Klangstrom/klangstrom-libraries/README.md

*Klangstrom* (KLST) is a subtractive infrastructure design framework to facilitate generative, networked, embedded sound + music + composition. *klangstrom* is comprised of two software libraries ( *klang* a node+text-based sound synthesis library and *strom* a node+text-based generative composition library ), an embedded hardware platform, and a programming environment to allow seamless development of generative, networked, embedded sound + music + composition applications.

---

contains a series of libraries that are mostly but not exclusively used by the *Arduino IDE* or `arduino-cli`. *klangstrom-libraries* are used ( as git *subtree* ) in the repositories *klangstrom-hardware* and *klangstrom-arduino*.

libraries included in *klangstrom-libraries*:

```sh
klangstrom-libraries
├── Klangstrom
├── Klangstrom_Emulator
├── Klangstrom_KLST_EMU                
├── Klangstrom_KLST_PANDA_STM32        
├── Klangstrom_KLST_PANDA_STM32_CubeMX 
├── USBDevices
└── USBHost # <- ⚠️ WIP ⚠️ currently broken
```

### Klangstrom

*Klangstrom* is the library that applications interact with. it defines the *Klangstrom API*. 

### Klangstrom_Emulator

infrastructure for running *Klangstrom* emulators. it is based on [Umfeld for Arduino](https://github.com/klangstrom/umfeld-arduino). it tries to mimic some *Arduino* functions but by far not every available function.

this library is usually not used directly.

### Klangstrom_KLST_EMU

implementation of *Klangstrom API* for running on the emulator. currently emulates *KLST_PANDA* and *KLST_CATERPILLAR*.

### Klangstrom_KLST_PANDA_STM32

implementation of board-specific (BSP) functions of the *Klangstrom API* for *KLST_PANDA* and *KLST_CATERPILLAR*.

this library is usually not used directly.

### Klangstrom_KLST_PANDA_STM32_CubeMX

low-level firmware files generated by STM32CubeMX with definitions found in the *project configuration files* ( `.ioc` ) in the `klangstrom-hardware` repository.

this library is usually not used directly.

### USBDevices

⚠️⚠️⚠️ WIP library is currently broken ⚠️⚠️⚠️

USB device library for STM32H7 devices. in USB terminology a *device* is a peripheral that is connect *to* a *host* e.g a keyboard, mouse or audio interface.

### USBHost

⚠️⚠️⚠️ WIP library is currently broken ⚠️⚠️⚠️ 

USB host library for STM32H7 devices. in USB terminology a *host* allows *devices* to connect to it. this library implements a sub-set of *Human-Interface Devices* (HID):

- keyboard
- mouse
- MIDI

<!-- 

## notes ==@todo==

- first initialize the hardware layer with `.init()` then setup device and peripherals with `.setup()` ( e.g start timers, data transfer, and callbacks )
- each board-specific (BSP) implementation is stored in it’s own library ( e.g `‌Klangstrom_KLST_PANDA_STM32` )

## environment

==@todo==

## Klangstrom

==@todo==
```
### File Naming Conventions

- `BSP` == Board Specific  > `KlangstromApplication_KLST_SHEEP-BSP`
- `SAB` == Shared Across Boards ( within an Architexture ) > `Klangstrom_ARDUINO-SAB.cpp`
```

==@todo("Klangstrom requires to set the environment in `KLST_ENV` at compile time. `KLST_ENV` defines architecture (`KLST_ARCH`) and board (`KLST_BOARD`):")==

```
KLST_ENV = KLST_ARCH + KLST_BOARD

.
├── KLST_ARCH                       (=0x10)
│   ├── KLST_ARCH_STM32             (=0x20) (Arduino,MCU) + (STM32CubeIDE,MCU)
│   └── KLST_ARCH_EMU               (=0x30) (Arduino,CPU)
└── KLST_BOARD                      (=0x01)
    ├── KLST_BOARD_KLST_CORE        (=0x02) (STM32H743+WM8731)
    ├── KLST_BOARD_KLST_TINY        (=0x03) (STM32F446+WM8731)
    ├── KLST_BOARD_KLST_SHEEP       (=0x04) (STM32H743+WM8731)
    ├── KLST_BOARD_KLST_PANDA       (=0x05) (STM32H723+WM8904)
    └── KLST_BOARD_KLST_CATERPILLAR (=0x06) (STM32H723+WM8904)
```

the following prepocessor conditionals can be used:

```
#if ((KLST_ENV & KLST_ARCH) == KLST_ARCH_STM32)
// running on STM32
#endif

#if ((KLST_ENV & KLST_BOARD) == KLST_BOARD_KLST_PANDA)
// running on KLST_PANDA
#endif
```

there are common files ( e.g `Klangstrom.cpp` ) and board-specific (BSP) files ( `Klangstrom-BSP-KLST_PANDA.cpp` ). the common files are used by all boards and architectures.

- `Klangstrom.h`
- `Klangstrom.cpp`
- `Klangstrom-KLST_PANDA.h`
- `Klangstrom-KLST_PANDA.cpp`
- `Klangstrom-Display.h`
- `Klangstrom-Display.cpp`
- `Klangstrom-KLST_PANDA-Display.h`
- `Klangstrom-KLST_PANDA-Display.cpp`
- ...

### architectures ==@todo==

available architectures are:

- SOFT/DESKTOP @TODO(need to decide on name)
- METAL/STM32 @TODO(need to decide on name)

programatically identifiable e.g

```
#if (KLST_ARCHITECTURE_METAL)
#endif // KLST_ARCHITECTURE_METAL
```

### boards ==@todo==

available boards are for `METAL`:

- `KLST_PANDA`
- `KLST_SHEEP`
- `KLST_TINY`

and for `SOFT`:

- `KLST_EMU`
- `KLST_STANDALONE` ==@todo== @NOTE(not sure about this one)

programatically identifiable e.g

```
#if defined(KLST_BOARD_KLST_PANDA)
#endif // KLST_BOARD_KLST_PANDA
```

## Board-Specific (BSP) implementations

all boards need to implement the following functions

```
KLST_BSP_init()
KLST_BSP_setup()
KLST_BSP_loop()
```

in a file called `Klangstrom_BSP_XXX.cpp` where `XXX` is the board and architecture ( e.g `KLST_PANDA_STM32` ).

### STM32

on `STM32` architecture this file usually also includes the HAL callbacks.

 -->
