Klangstrom/klangstrom-libraries/Klangstrom_KLST_PANDA_STM32_CubeMX/src/main.h

#define KLST_DISPLAY_FRAMEBUFFER_ADDRESS   0x90000000
#define KLST_DISPLAY_WIDTH                 480
#define KLST_DISPLAY_HEIGHT                272
#define SPI_USR_SCK_Pin                    GPIO_PIN_2
#define SPI_USR_SCK_GPIO_Port              GPIOE
#define _AUDIO_CODEC_SAI_SD_OUT_Pin        GPIO_PIN_3
#define _AUDIO_CODEC_SAI_SD_OUT_GPIO_Port  GPIOE
#define SPI_USR_CS_Pin                     GPIO_PIN_4
#define SPI_USR_CS_GPIO_Port               GPIOE
#define SPI_USR_MISO_Pin                   GPIO_PIN_5
#define SPI_USR_MISO_GPIO_Port             GPIOE
#define SPI_USR_MOSI_Pin                   GPIO_PIN_6
#define SPI_USR_MOSI_GPIO_Port             GPIOE
#define GPIO_10_Pin                        GPIO_PIN_13
#define GPIO_10_GPIO_Port                  GPIOC
#define GPIO_09_Pin                        GPIO_PIN_14
#define GPIO_09_GPIO_Port                  GPIOC
#define GPIO_08_Pin                        GPIO_PIN_15
#define GPIO_08_GPIO_Port                  GPIOC
#define GPIO_03_PWM_Pin                    GPIO_PIN_0
#define GPIO_03_PWM_GPIO_Port              GPIOF
#define GPIO_02_PWM_Pin                    GPIO_PIN_1
#define GPIO_02_PWM_GPIO_Port              GPIOF
#define GPIO_01_PWM_Pin                    GPIO_PIN_2
#define GPIO_01_PWM_GPIO_Port              GPIOF
#define GPIO_00_PWM_Pin                    GPIO_PIN_3
#define GPIO_00_PWM_GPIO_Port              GPIOF
#define GPIO_07_Pin                        GPIO_PIN_4
#define GPIO_07_GPIO_Port                  GPIOF
#define _ADC_USR_Pin                       GPIO_PIN_5
#define _ADC_USR_GPIO_Port                 GPIOF
#define _EXT_MEMORY_A3_Pin                 GPIO_PIN_6
#define _EXT_MEMORY_A3_GPIO_Port           GPIOF
#define _AUDIO_CODEC_SAI_MCLK_Pin          GPIO_PIN_7
#define _AUDIO_CODEC_SAI_MCLK_GPIO_Port    GPIOF
#define _AUDIO_CODEC_SAI_SCK_Pin           GPIO_PIN_8
#define _AUDIO_CODEC_SAI_SCK_GPIO_Port     GPIOF
#define _AUDIO_CODEC_SAI_FS_Pin            GPIO_PIN_9
#define _AUDIO_CODEC_SAI_FS_GPIO_Port      GPIOF
#define _EXT_MEMORY_CLK_Pin                GPIO_PIN_10
#define _EXT_MEMORY_CLK_GPIO_Port          GPIOF
#define _RCC_OSC_IN_Pin                    GPIO_PIN_0
#define _RCC_OSC_IN_GPIO_Port              GPIOH
#define _RCC_OSC_OUT_Pin                   GPIO_PIN_1
#define _RCC_OSC_OUT_GPIO_Port             GPIOH
#define _DISPLAY_LTDC_R5_Pin               GPIO_PIN_0
#define _DISPLAY_LTDC_R5_GPIO_Port         GPIOC
#define _DISPLAY_LTDC_G5_Pin               GPIO_PIN_1
#define _DISPLAY_LTDC_G5_GPIO_Port         GPIOC
#define _AUDIO_MIC_CLK_Pin                 GPIO_PIN_2
#define _AUDIO_MIC_CLK_GPIO_Port           GPIOC
#define _AUDIO_MIC_DATA_Pin                GPIO_PIN_3
#define _AUDIO_MIC_DATA_GPIO_Port          GPIOC
#define _ENCODER_01_A_Pin                  GPIO_PIN_0
#define _ENCODER_01_A_GPIO_Port            GPIOA
#define _ENCODER_01_B_Pin                  GPIO_PIN_1
#define _ENCODER_01_B_GPIO_Port            GPIOA
#define _DISPLAY_LTDC_R1_Pin               GPIO_PIN_2
#define _DISPLAY_LTDC_R1_GPIO_Port         GPIOA
#define SERIAL_USR_RX_Pin                  GPIO_PIN_3
#define SERIAL_USR_RX_GPIO_Port            GPIOA
#define _DAC_USR_Pin                       GPIO_PIN_4
#define _DAC_USR_GPIO_Port                 GPIOA
#define _DISPLAY_LTDC_R4_Pin               GPIO_PIN_5
#define _DISPLAY_LTDC_R4_GPIO_Port         GPIOA
#define _DISPLAY_LTDC_G2_Pin               GPIO_PIN_6
#define _DISPLAY_LTDC_G2_GPIO_Port         GPIOA
#define _DISPLAY_LTDC_VSYNC_Pin            GPIO_PIN_7
#define _DISPLAY_LTDC_VSYNC_GPIO_Port      GPIOA
#define _DISPLAY_ON_OFF_Pin                GPIO_PIN_4
#define _DISPLAY_ON_OFF_GPIO_Port          GPIOC
#define _EXT_MEMORY_DQS_Pin                GPIO_PIN_5
#define _EXT_MEMORY_DQS_GPIO_Port          GPIOC
#define _DISPLAY_LTDC_G1_Pin               GPIO_PIN_0
#define _DISPLAY_LTDC_G1_GPIO_Port         GPIOB
#define _DISPLAY_LTDC_G0_Pin               GPIO_PIN_1
#define _DISPLAY_LTDC_G0_GPIO_Port         GPIOB
#define _AUDIO_CODEC_SAI_SD_IN_Pin         GPIO_PIN_2
#define _AUDIO_CODEC_SAI_SD_IN_GPIO_Port   GPIOB
#define GPIO_05_ADC_Pin                    GPIO_PIN_11
#define GPIO_05_ADC_GPIO_Port              GPIOF
#define _BUTTON_PROGRAMMER_Pin             GPIO_PIN_12
#define _BUTTON_PROGRAMMER_GPIO_Port       GPIOF
#define GPIO_04_ADC_Pin                    GPIO_PIN_13
#define GPIO_04_ADC_GPIO_Port              GPIOF
#define _I2C_PERIPHERAL_SCL_Pin            GPIO_PIN_14
#define _I2C_PERIPHERAL_SCL_GPIO_Port      GPIOF
#define _I2C_PERIPHERAL_SDA_Pin            GPIO_PIN_15
#define _I2C_PERIPHERAL_SDA_GPIO_Port      GPIOF
#define _IDC_SERIAL_01_RX_Pin              GPIO_PIN_0
#define _IDC_SERIAL_01_RX_GPIO_Port        GPIOG
#define _IDC_SERIAL_01_TX_Pin              GPIO_PIN_1
#define _IDC_SERIAL_01_TX_GPIO_Port        GPIOG
#define _EXT_MEMORY_A4_Pin                 GPIO_PIN_7
#define _EXT_MEMORY_A4_GPIO_Port           GPIOE
#define _EXT_MEMORY_A5_Pin                 GPIO_PIN_8
#define _EXT_MEMORY_A5_GPIO_Port           GPIOE
#define _EXT_MEMORY_A6_Pin                 GPIO_PIN_9
#define _EXT_MEMORY_A6_GPIO_Port           GPIOE
#define _EXT_MEMORY_A7_Pin                 GPIO_PIN_10
#define _EXT_MEMORY_A7_GPIO_Port           GPIOE
#define _ENCODER_00_B_Pin                  GPIO_PIN_11
#define _ENCODER_00_B_GPIO_Port            GPIOE
#define _DISPLAY_LTDC_B4_Pin               GPIO_PIN_12
#define _DISPLAY_LTDC_B4_GPIO_Port         GPIOE
#define _DISPLAY_LTDC_DE_Pin               GPIO_PIN_13
#define _DISPLAY_LTDC_DE_GPIO_Port         GPIOE
#define GPIO_17_Pin                        GPIO_PIN_14
#define GPIO_17_GPIO_Port                  GPIOE
#define _DISPLAY_LTDC_R7_Pin               GPIO_PIN_15
#define _DISPLAY_LTDC_R7_GPIO_Port         GPIOE
#define _DISPLAY_LTDC_G4_Pin               GPIO_PIN_10
#define _DISPLAY_LTDC_G4_GPIO_Port         GPIOB
#define _ENCODER_01_BUTTON_Pin             GPIO_PIN_11
#define _ENCODER_01_BUTTON_GPIO_Port       GPIOB
#define _EXT_MEMORY_A0_Pin                 GPIO_PIN_12
#define _EXT_MEMORY_A0_GPIO_Port           GPIOB
#define _EXT_MEMORY_A2_Pin                 GPIO_PIN_13
#define _EXT_MEMORY_A2_GPIO_Port           GPIOB
#define _LED_00_Pin                        GPIO_PIN_14
#define _LED_00_GPIO_Port                  GPIOB
#define _LED_01_Pin                        GPIO_PIN_15
#define _LED_01_GPIO_Port                  GPIOB
#define _SERIAL_DEBUG_TX_Pin               GPIO_PIN_8
#define _SERIAL_DEBUG_TX_GPIO_Port         GPIOD
#define _SERIAL_DEBUG_RX_Pin               GPIO_PIN_9
#define _SERIAL_DEBUG_RX_GPIO_Port         GPIOD
#define _DISPLAY_LTDC_B3_Pin               GPIO_PIN_10
#define _DISPLAY_LTDC_B3_GPIO_Port         GPIOD
#define GPIO_06_Pin                        GPIO_PIN_11
#define GPIO_06_GPIO_Port                  GPIOD
#define _EXT_MEMORY_A1_Pin                 GPIO_PIN_12
#define _EXT_MEMORY_A1_GPIO_Port           GPIOD
#define _DISPLAY_TOUCH_INTERRUPT_Pin       GPIO_PIN_13
#define _DISPLAY_TOUCH_INTERRUPT_GPIO_Port GPIOD
#define _DISPLAY_TOUCH_INTERRUPT_EXTI_IRQn EXTI15_10_IRQn
#define _MECH_BUTTON_00_Pin                GPIO_PIN_14
#define _MECH_BUTTON_00_GPIO_Port          GPIOD
#define _MECH_BUTTON_00_EXTI_IRQn          EXTI15_10_IRQn
#define _MECH_BUTTON_01_Pin                GPIO_PIN_15
#define _MECH_BUTTON_01_GPIO_Port          GPIOD
#define _MECH_BUTTON_01_EXTI_IRQn          EXTI15_10_IRQn
#define GPIO_16_Pin                        GPIO_PIN_2
#define GPIO_16_GPIO_Port                  GPIOG
#define GPIO_15_Pin                        GPIO_PIN_3
#define GPIO_15_GPIO_Port                  GPIOG
#define GPIO_14_Pin                        GPIO_PIN_4
#define GPIO_14_GPIO_Port                  GPIOG
#define GPIO_13_Pin                        GPIO_PIN_5
#define GPIO_13_GPIO_Port                  GPIOG
#define _EXT_MEMORY_CHIP_SELECT_Pin        GPIO_PIN_6
#define _EXT_MEMORY_CHIP_SELECT_GPIO_Port  GPIOG
#define _DISPLAY_LTDC_CLK_Pin              GPIO_PIN_7
#define _DISPLAY_LTDC_CLK_GPIO_Port        GPIOG
#define _DISPLAY_LTDC_G7_Pin               GPIO_PIN_8
#define _DISPLAY_LTDC_G7_GPIO_Port         GPIOG
#define _DISPLAY_LTDC_HSYNC_Pin            GPIO_PIN_6
#define _DISPLAY_LTDC_HSYNC_GPIO_Port      GPIOC
#define _DISPLAY_LTDC_G6_Pin               GPIO_PIN_7
#define _DISPLAY_LTDC_G6_GPIO_Port         GPIOC
#define _DISPLAY_BACKLIGHT_PWM_Pin         GPIO_PIN_8
#define _DISPLAY_BACKLIGHT_PWM_GPIO_Port   GPIOC
#define _DISPLAY_LTDC_G3_Pin               GPIO_PIN_9
#define _DISPLAY_LTDC_G3_GPIO_Port         GPIOC
#define _ENCODER_00_A_Pin                  GPIO_PIN_8
#define _ENCODER_00_A_GPIO_Port            GPIOA
#define _USB_DEVICE_HOST_VBUS_Pin          GPIO_PIN_9
#define _USB_DEVICE_HOST_VBUS_GPIO_Port    GPIOA
#define _ENCODER_00_BUTTON_Pin             GPIO_PIN_10
#define _ENCODER_00_BUTTON_GPIO_Port       GPIOA
#define _USB_DEVICE_HOST_MINUS_Pin         GPIO_PIN_11
#define _USB_DEVICE_HOST_MINUS_GPIO_Port   GPIOA
#define _USB_DEVICE_HOST_PLUS_Pin          GPIO_PIN_12
#define _USB_DEVICE_HOST_PLUS_GPIO_Port    GPIOA
#define _SWD_IO_Pin                        GPIO_PIN_13
#define _SWD_IO_GPIO_Port                  GPIOA
#define _SWD_CLK_Pin                       GPIO_PIN_14
#define _SWD_CLK_GPIO_Port                 GPIOA
#define _DISPLAY_LTDC_R3_Pin               GPIO_PIN_15
#define _DISPLAY_LTDC_R3_GPIO_Port         GPIOA
#define _DISPLAY_LTDC_R2_Pin               GPIO_PIN_10
#define _DISPLAY_LTDC_R2_GPIO_Port         GPIOC
#define _MIDI_ANALOG_IN_Pin                GPIO_PIN_11
#define _MIDI_ANALOG_IN_GPIO_Port          GPIOC
#define _DISPLAY_LTDC_R6_Pin               GPIO_PIN_12
#define _DISPLAY_LTDC_R6_GPIO_Port         GPIOC
#define _DISPLAY_LTDC_B1_Pin               GPIO_PIN_0
#define _DISPLAY_LTDC_B1_GPIO_Port         GPIOD
#define _MIDI_ANALOG_OUT_Pin               GPIO_PIN_1
#define _MIDI_ANALOG_OUT_GPIO_Port         GPIOD
#define _DISPLAY_LTDC_B2_Pin               GPIO_PIN_2
#define _DISPLAY_LTDC_B2_GPIO_Port         GPIOD
#define GPIO_18_Pin                        GPIO_PIN_3
#define GPIO_18_GPIO_Port                  GPIOD
#define GPIO_12_Pin                        GPIO_PIN_4
#define GPIO_12_GPIO_Port                  GPIOD
#define SERIAL_USR_TX_Pin                  GPIO_PIN_5
#define SERIAL_USR_TX_GPIO_Port            GPIOD
#define _CARD_SDMMC_CK_Pin                 GPIO_PIN_6
#define _CARD_SDMMC_CK_GPIO_Port           GPIOD
#define _CARD_SDMMC_CMD_Pin                GPIO_PIN_7
#define _CARD_SDMMC_CMD_GPIO_Port          GPIOD
#define _CARD_SDMMC_D0_Pin                 GPIO_PIN_9
#define _CARD_SDMMC_D0_GPIO_Port           GPIOG
#define _CARD_SDMMC_D1_Pin                 GPIO_PIN_10
#define _CARD_SDMMC_D1_GPIO_Port           GPIOG
#define _CARD_SDMMC_D2_Pin                 GPIO_PIN_11
#define _CARD_SDMMC_D2_GPIO_Port           GPIOG
#define _CARD_SDMMC_D3_Pin                 GPIO_PIN_12
#define _CARD_SDMMC_D3_GPIO_Port           GPIOG
#define _DISPLAY_LTDC_R0_Pin               GPIO_PIN_13
#define _DISPLAY_LTDC_R0_GPIO_Port         GPIOG
#define _DISPLAY_LTDC_B0_Pin               GPIO_PIN_14
#define _DISPLAY_LTDC_B0_GPIO_Port         GPIOG
#define _CARD_SDMMC_CHIP_DETECT_Pin        GPIO_PIN_15
#define _CARD_SDMMC_CHIP_DETECT_GPIO_Port  GPIOG
#define _SWD_OUT_Pin                       GPIO_PIN_3
#define _SWD_OUT_GPIO_Port                 GPIOB
#define GPIO_11_Pin                        GPIO_PIN_4
#define GPIO_11_GPIO_Port                  GPIOB
#define _DISPLAY_LTDC_B5_Pin               GPIO_PIN_5
#define _DISPLAY_LTDC_B5_GPIO_Port         GPIOB
#define I2C_USR_SCL_Pin                    GPIO_PIN_6
#define I2C_USR_SCL_GPIO_Port              GPIOB
#define I2C_USR_SDA_Pin                    GPIO_PIN_7
#define I2C_USR_SDA_GPIO_Port              GPIOB
#define _DISPLAY_LTDC_B6_Pin               GPIO_PIN_8
#define _DISPLAY_LTDC_B6_GPIO_Port         GPIOB
#define _DISPLAY_LTDC_B7_Pin               GPIO_PIN_9
#define _DISPLAY_LTDC_B7_GPIO_Port         GPIOB
#define _IDC_SERIAL_00_RX_Pin              GPIO_PIN_0
#define _IDC_SERIAL_00_RX_GPIO_Port        GPIOE
#define _IDC_SERIAL_00_TX_Pin              GPIO_PIN_1
#define _IDC_SERIAL_00_TX_GPIO_Port        GPIOE
