Klangstrom/klangstrom-libraries/Klangstrom/src/KlangstromEnvironment.h

/*
 * Klangstrom
 *
 * This file is part of the *Klangstrom* library (https://github.com/dennisppaul/klangstrom-libraries).
 * Copyright (c) 2025 Dennis P Paul.
 *
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
 * You should have received a copy of the GNU General Public License
 * along with this program. If not, see <http://www.gnu.org/licenses/>.
 */

/* --- THIS FILE IS AUTOGENERATED --- */

#pragma once

// #define KLST_DEBUG_ENVIRONMENT

#define KLST_ARCH 0x10
#define KLST_ARCH_RESERVED 0x20
#define KLST_ARCH_STM32 0x30
#define KLST_ARCH_EMU 0x40
#define KLST_ARCH_MASK 0xF0

#define KLST_BOARD 0x01
#define KLST_BOARD_GENERIC 0x02
#define KLST_BOARD_KLST_CORE 0x03
#define KLST_BOARD_KLST_TINY 0x04
#define KLST_BOARD_KLST_SHEEP 0x05
#define KLST_BOARD_KLST_PANDA 0x06
#define KLST_BOARD_KLST_CATERPILLAR 0x07
#define KLST_BOARD_MASK 0x0F

#ifndef KLST_ENV
#error "define KLST_ENV with (KLST_ARCH | KLST_BOARD) or (KLST_ARCH + KLST_BOARD) e.g KLST_PANDA on STM32: (KLST_BOARD_KLST_PANDA + KLST_ARCH_STM32) = (0x20 + 0x05) = 0x25"

#else

// GENERIC

#if ((KLST_ENV & KLST_BOARD_MASK) == KLST_BOARD_GENERIC) && ((KLST_ENV & KLST_ARCH_MASK) == KLST_ARCH_RESERVED)
#define KLST_ARCH_IS_RESERVED
#define GENERIC_RESERVED // = 0x22
#ifdef KLST_DEBUG_ENVIRONMENT
#warning "+++ klangstrom platform: GENERIC_RESERVED"
#endif // KLST_DEBUG_ENVIRONMENT
#endif // GENERIC_RESERVED

#if ((KLST_ENV & KLST_BOARD_MASK) == KLST_BOARD_GENERIC) && ((KLST_ENV & KLST_ARCH_MASK) == KLST_ARCH_STM32)
#define KLST_ARCH_IS_STM32
#define GENERIC_STM32 // = 0x32
#ifdef KLST_DEBUG_ENVIRONMENT
#warning "+++ klangstrom platform: GENERIC_STM32"
#endif // KLST_DEBUG_ENVIRONMENT
#endif // GENERIC_STM32

#if ((KLST_ENV & KLST_BOARD_MASK) == KLST_BOARD_GENERIC) && ((KLST_ENV & KLST_ARCH_MASK) == KLST_ARCH_EMU)
#define KLST_ARCH_IS_EMU
#define GENERIC_EMU // = 0x42
#ifdef KLST_DEBUG_ENVIRONMENT
#warning "+++ klangstrom platform: GENERIC_EMU"
#endif // KLST_DEBUG_ENVIRONMENT
#endif // GENERIC_EMU

// KLST_CORE

#if ((KLST_ENV & KLST_BOARD_MASK) == KLST_BOARD_KLST_CORE) && ((KLST_ENV & KLST_ARCH_MASK) == KLST_ARCH_RESERVED)
#define KLST_ARCH_IS_RESERVED
#define KLST_CORE_RESERVED // = 0x23
#ifdef KLST_DEBUG_ENVIRONMENT
#warning "+++ klangstrom platform: KLST_CORE_RESERVED"
#endif // KLST_DEBUG_ENVIRONMENT
#endif // KLST_CORE_RESERVED

#if ((KLST_ENV & KLST_BOARD_MASK) == KLST_BOARD_KLST_CORE) && ((KLST_ENV & KLST_ARCH_MASK) == KLST_ARCH_STM32)
#define KLST_ARCH_IS_STM32
#define KLST_CORE_STM32 // = 0x33
#ifdef KLST_DEBUG_ENVIRONMENT
#warning "+++ klangstrom platform: KLST_CORE_STM32"
#endif // KLST_DEBUG_ENVIRONMENT
#endif // KLST_CORE_STM32

#if ((KLST_ENV & KLST_BOARD_MASK) == KLST_BOARD_KLST_CORE) && ((KLST_ENV & KLST_ARCH_MASK) == KLST_ARCH_EMU)
#define KLST_ARCH_IS_EMU
#define KLST_CORE_EMU // = 0x43
#ifdef KLST_DEBUG_ENVIRONMENT
#warning "+++ klangstrom platform: KLST_CORE_EMU"
#endif // KLST_DEBUG_ENVIRONMENT
#endif // KLST_CORE_EMU

// KLST_TINY

#if ((KLST_ENV & KLST_BOARD_MASK) == KLST_BOARD_KLST_TINY) && ((KLST_ENV & KLST_ARCH_MASK) == KLST_ARCH_RESERVED)
#define KLST_ARCH_IS_RESERVED
#define KLST_TINY_RESERVED // = 0x24
#ifdef KLST_DEBUG_ENVIRONMENT
#warning "+++ klangstrom platform: KLST_TINY_RESERVED"
#endif // KLST_DEBUG_ENVIRONMENT
#endif // KLST_TINY_RESERVED

#if ((KLST_ENV & KLST_BOARD_MASK) == KLST_BOARD_KLST_TINY) && ((KLST_ENV & KLST_ARCH_MASK) == KLST_ARCH_STM32)
#define KLST_ARCH_IS_STM32
#define KLST_TINY_STM32 // = 0x34
#ifdef KLST_DEBUG_ENVIRONMENT
#warning "+++ klangstrom platform: KLST_TINY_STM32"
#endif // KLST_DEBUG_ENVIRONMENT
#endif // KLST_TINY_STM32

#if ((KLST_ENV & KLST_BOARD_MASK) == KLST_BOARD_KLST_TINY) && ((KLST_ENV & KLST_ARCH_MASK) == KLST_ARCH_EMU)
#define KLST_ARCH_IS_EMU
#define KLST_TINY_EMU // = 0x44
#ifdef KLST_DEBUG_ENVIRONMENT
#warning "+++ klangstrom platform: KLST_TINY_EMU"
#endif // KLST_DEBUG_ENVIRONMENT
#endif // KLST_TINY_EMU

// KLST_SHEEP

#if ((KLST_ENV & KLST_BOARD_MASK) == KLST_BOARD_KLST_SHEEP) && ((KLST_ENV & KLST_ARCH_MASK) == KLST_ARCH_RESERVED)
#define KLST_ARCH_IS_RESERVED
#define KLST_SHEEP_RESERVED // = 0x25
#ifdef KLST_DEBUG_ENVIRONMENT
#warning "+++ klangstrom platform: KLST_SHEEP_RESERVED"
#endif // KLST_DEBUG_ENVIRONMENT
#endif // KLST_SHEEP_RESERVED

#if ((KLST_ENV & KLST_BOARD_MASK) == KLST_BOARD_KLST_SHEEP) && ((KLST_ENV & KLST_ARCH_MASK) == KLST_ARCH_STM32)
#define KLST_ARCH_IS_STM32
#define KLST_SHEEP_STM32 // = 0x35
#ifdef KLST_DEBUG_ENVIRONMENT
#warning "+++ klangstrom platform: KLST_SHEEP_STM32"
#endif // KLST_DEBUG_ENVIRONMENT
#endif // KLST_SHEEP_STM32

#if ((KLST_ENV & KLST_BOARD_MASK) == KLST_BOARD_KLST_SHEEP) && ((KLST_ENV & KLST_ARCH_MASK) == KLST_ARCH_EMU)
#define KLST_ARCH_IS_EMU
#define KLST_SHEEP_EMU // = 0x45
#ifdef KLST_DEBUG_ENVIRONMENT
#warning "+++ klangstrom platform: KLST_SHEEP_EMU"
#endif // KLST_DEBUG_ENVIRONMENT
#endif // KLST_SHEEP_EMU

// KLST_PANDA

#if ((KLST_ENV & KLST_BOARD_MASK) == KLST_BOARD_KLST_PANDA) && ((KLST_ENV & KLST_ARCH_MASK) == KLST_ARCH_RESERVED)
#define KLST_ARCH_IS_RESERVED
#define KLST_PANDA_RESERVED // = 0x26
#ifdef KLST_DEBUG_ENVIRONMENT
#warning "+++ klangstrom platform: KLST_PANDA_RESERVED"
#endif // KLST_DEBUG_ENVIRONMENT
#endif // KLST_PANDA_RESERVED

#if ((KLST_ENV & KLST_BOARD_MASK) == KLST_BOARD_KLST_PANDA) && ((KLST_ENV & KLST_ARCH_MASK) == KLST_ARCH_STM32)
#define KLST_ARCH_IS_STM32
#define KLST_PANDA_STM32 // = 0x36
#ifdef KLST_DEBUG_ENVIRONMENT
#warning "+++ klangstrom platform: KLST_PANDA_STM32"
#endif // KLST_DEBUG_ENVIRONMENT
#endif // KLST_PANDA_STM32

#if ((KLST_ENV & KLST_BOARD_MASK) == KLST_BOARD_KLST_PANDA) && ((KLST_ENV & KLST_ARCH_MASK) == KLST_ARCH_EMU)
#define KLST_ARCH_IS_EMU
#define KLST_PANDA_EMU // = 0x46
#ifdef KLST_DEBUG_ENVIRONMENT
#warning "+++ klangstrom platform: KLST_PANDA_EMU"
#endif // KLST_DEBUG_ENVIRONMENT
#endif // KLST_PANDA_EMU

// KLST_CATERPILLAR

#if ((KLST_ENV & KLST_BOARD_MASK) == KLST_BOARD_KLST_CATERPILLAR) && ((KLST_ENV & KLST_ARCH_MASK) == KLST_ARCH_RESERVED)
#define KLST_ARCH_IS_RESERVED
#define KLST_CATERPILLAR_RESERVED // = 0x27
#ifdef KLST_DEBUG_ENVIRONMENT
#warning "+++ klangstrom platform: KLST_CATERPILLAR_RESERVED"
#endif // KLST_DEBUG_ENVIRONMENT
#endif // KLST_CATERPILLAR_RESERVED

#if ((KLST_ENV & KLST_BOARD_MASK) == KLST_BOARD_KLST_CATERPILLAR) && ((KLST_ENV & KLST_ARCH_MASK) == KLST_ARCH_STM32)
#define KLST_ARCH_IS_STM32
#define KLST_CATERPILLAR_STM32 // = 0x37
#ifdef KLST_DEBUG_ENVIRONMENT
#warning "+++ klangstrom platform: KLST_CATERPILLAR_STM32"
#endif // KLST_DEBUG_ENVIRONMENT
#endif // KLST_CATERPILLAR_STM32

#if ((KLST_ENV & KLST_BOARD_MASK) == KLST_BOARD_KLST_CATERPILLAR) && ((KLST_ENV & KLST_ARCH_MASK) == KLST_ARCH_EMU)
#define KLST_ARCH_IS_EMU
#define KLST_CATERPILLAR_EMU // = 0x47
#ifdef KLST_DEBUG_ENVIRONMENT
#warning "+++ klangstrom platform: KLST_CATERPILLAR_EMU"
#endif // KLST_DEBUG_ENVIRONMENT
#endif // KLST_CATERPILLAR_EMU

#endif // KLST_ENV
