Klangstrom/klangstrom-libraries/Klangstrom_Emulator/standalone/src/MWavetable.h

/*
 * Klangwellen
 *
 * This file is part of the *Klangwellen* library (https://github.com/dennisppaul/klangwellen).
 * Copyright (c) 2025 Dennis P Paul
 *
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
 * You should have received a copy of the GNU General Public License
 * along with this program. If not, see <http://www.gnu.org/licenses/>.
 */

/**
 * PROCESSOR INTERFACE
 *
 * - [x] float process()
 * - [ ] float process(float)
 * - [ ] void process(Signal&)
 * - [x] void process(float*, uint32_t) *overwrite*
 * - [ ] void process(float*, float*, uint32_t)
 */

#pragma once

#include <stdint.h>
#include <math.h>

#ifndef PI
#define PI M_PI
#endif

#ifndef TWO_PI
#define TWO_PI (M_PI * 2)
#endif

#ifndef HALF_PI
#define HALF_PI (M_PI / 2)
#endif

/**
 * plays back a chunk of samples ( i.e arbitrary, single-cycle waveform like sine, triangle, saw or square waves ) at
 * different frequencies and amplitudes.
 */
class MWavetable {
public:
    static constexpr uint8_t WAVEFORM_SINE                = 0;
    static constexpr uint8_t WAVEFORM_TRIANGLE            = 1;
    static constexpr uint8_t WAVEFORM_SQUARE              = 3;
    static constexpr uint8_t WAVESHAPE_INTERPOLATE_NONE   = 0;
    static constexpr uint8_t WAVESHAPE_INTERPOLATE_LINEAR = 1;
    static constexpr uint8_t WAVESHAPE_INTERPOLATE_CUBIC  = 2;


    MWavetable(float* wavetable, const uint32_t wavetable_size, const uint32_t sampling_rate) : mWavetableSize(wavetable_size),
                                                                                               mSamplingRate(sampling_rate),
                                                                                               mFrequency(0) {
        mWavetable                = wavetable;
        fDeleteWavetable          = false;
        mArrayPtr                 = 0;
        mJitterRange              = 0.0f;
        mAmplitude                = M_DEFAULT_AMPLITUDE;
        mPhaseOffset              = 0.0f;
        mDesiredAmplitude         = 0.0f;
        mDesiredAmplitudeFraction = 0.0f;
        mDesiredAmplitudeSteps    = 0;
        set_frequency(M_DEFAULT_FREQUENCY);
    }

    ~MWavetable() {
        if (fDeleteWavetable) {
            delete[] mWavetable;
        }
    }

    static void fill(float* wavetable, const uint32_t wavetable_size, const uint8_t waveform) {
        switch (waveform) {
            case WAVEFORM_SINE:
                sine(wavetable, wavetable_size);
                break;
            case WAVEFORM_TRIANGLE:
                triangle(wavetable, wavetable_size);
                break;
            case WAVEFORM_SQUARE:
                square(wavetable, wavetable_size);
                break;
            default:
                sine(wavetable, wavetable_size);
        }
    }

    static void pulse(float* wavetable, const uint32_t wavetable_size, const float pulse_width) {
        const uint32_t mThreshold = static_cast<uint32_t>(wavetable_size * pulse_width);
        for (uint32_t i = 0; i < wavetable_size; i++) {
            if (i < mThreshold) {
                wavetable[i] = 1.0f;
            } else {
                wavetable[i] = -1.0f;
            }
        }
    }

    static void sawtooth_ramp(float* wavetable, const uint32_t wavetable_size, const bool is_ramp_up) {
        const float mSign = is_ramp_up ? -1.0f : 1.0f;
        for (uint32_t i = 0; i < wavetable_size; i++) {
            wavetable[i] = mSign * (2.0f * (static_cast<float>(i) / static_cast<float>(wavetable_size - 1)) - 1.0f);
        }
    }

    static void sine(float* wavetable, const uint32_t wavetable_size) {
        for (uint32_t i = 0; i < wavetable_size; i++) {
            wavetable[i] = sin(2.0f * PIf * (static_cast<float>(i) / static_cast<float>(wavetable_size)));
        }
    }

    static void square(float* wavetable, const uint32_t wavetable_size) {
        for (uint32_t i = 0; i < wavetable_size / 2; i++) {
            wavetable[i]                      = 1.0f;
            wavetable[i + wavetable_size / 2] = -1.0f;
        }
    }

    static void triangle(float* wavetable, const uint32_t wavetable_size) {
        const uint32_t q  = wavetable_size / 4;
        const float    qf = wavetable_size * 0.25f;
        for (uint32_t i = 0; i < q; i++) {
            wavetable[i] = i / qf;
            // noinspection PointlessArithmeticExpression
            wavetable[i + (q * 1)] = (qf - i) / qf;
            wavetable[i + (q * 2)] = -i / qf;
            wavetable[i + (q * 3)] = -(qf - i) / qf;
        }
    }

    void set_waveform(const uint8_t waveform) const {
        fill(mWavetable, mWavetableSize, waveform);
    }

    float get_frequency() const {
        return mFrequency;
    }

    void set_frequency(const float frequency) {
        const float mNewFrequency = fabs(frequency);
        if (mFrequency != mNewFrequency) {
            mFrequency = mNewFrequency;
            mStepSize  = computeStepSize();
        }
    }

    /**
     * alternative version of `set_frequency` which takes a second paramter that specifies the duration in samples from
     * current to new value. this can prevent unwanted artifacts ( e.g when quickly changing values ). it can also be
     * used to create glissando or portamento effects.
     *
     * @param frequency                         destination frequency
     * @param interpolation_duration_in_samples duration of interpolation in samples
     */
    void set_frequency(const float frequency, const uint16_t interpolation_duration_in_samples) {
        if (interpolation_duration_in_samples > 0) {
            mDesiredFrequency           = frequency;
            mDesiredFrequencySteps      = interpolation_duration_in_samples;
            const float mFrequencyDelta = mDesiredFrequency - mFrequency;
            mDesiredFrequencyFraction   = mFrequencyDelta / interpolation_duration_in_samples;
        } else {
            set_frequency(frequency);
        }
    }

    float get_offset() const {
        return mOffset;
    }

    void set_offset(const float offset) {
        mOffset = offset;
    }

    float get_amplitude() const {
        return mAmplitude;
    }

    /**
     * @param amplitude amplitude
     */

    void set_amplitude(const float amplitude) {
        mAmplitude             = amplitude;
        mDesiredAmplitudeSteps = 0;
    }

    /**
     * alternative version of `set_amplitude` which takes a second paramter that specifies the duration in samples from
     * current to new value. this can prevent unwanted artifacts ( e.g crackling noise when changing amplitude quickly
     * especially on smoother wave shape like sine waves ). it can also be used to create glissando or portamento
     * effects.
     *
     * @param amplitude                         destination amplitude
     * @param interpolation_duration_in_samples duration of interpolation in samples
     */
    void set_amplitude(const float amplitude, const uint32_t interpolation_duration_in_samples) {
        if (interpolation_duration_in_samples > 0) {
            mDesiredAmplitude           = amplitude;
            mDesiredAmplitudeSteps      = interpolation_duration_in_samples;
            const float mAmplitudeDelta = mDesiredAmplitude - mAmplitude;
            mDesiredAmplitudeFraction   = mAmplitudeDelta / interpolation_duration_in_samples;
        } else {
            set_amplitude(amplitude);
        }
    }

    float* get_wavetable() const {
        return mWavetable;
    }

    uint32_t get_wavetable_size() const {
        return mWavetableSize;
    }

    float get_phase_offset() const {
        return mPhaseOffset;
    }

    void set_phase_offset(const float phase_offset) {
        mPhaseOffset = phase_offset < 0 ? 1 + phase_offset : phase_offset;
    }

    float get_jitter_range() const {
        return mJitterRange;
    }

    void set_jitter_range(const float jitter_range) {
        mJitterRange = jitter_range;
    }

    void reset() {
        mSignal   = 0.0f;
        mArrayPtr = 0.0f;
    }

    float current() const {
        return mSignal;
    }

    /**
     * set speed of oscillator in seconds per phase
     *
     * @param frequency oscillation speed on seconds per phase ( or Hz )
     */
    void set_oscillation_speed(const float frequency) {
        set_frequency(1.0f / frequency);
    }

    /**
     * set output value range of oscillator in minimum and maximum. this method affects the oscillator’s amplitude and
     * offset. this methods can be particularily helpful when using an oscillator for non-audio applications ( e.g as an
     * LFO that controlls the frequency ).
     *
     * @param min minimum output value of oscillator
     * @param max maximum output value of oscillator
     */
    void set_oscillation_range(const float min, const float max) {
        const float mDelta = max - min;
        set_amplitude(mDelta * 0.5f);
        set_offset(mDelta * 0.5f + min);
    }

    float process() {
        if (mDesiredAmplitudeSteps > 0) {
            mDesiredAmplitudeSteps--;
            if (mDesiredAmplitudeSteps == 0) {
                mAmplitude = mDesiredAmplitude;
            } else {
                mAmplitude += mDesiredAmplitudeFraction;
            }
        }

        if (mDesiredFrequencySteps > 0) {
            mDesiredFrequencySteps--;
            if (mDesiredFrequencySteps == 0) {
                set_frequency(mDesiredFrequency);
            } else {
                set_frequency(mFrequency + mDesiredFrequencyFraction);
            }
        }

        mSignal = next_sample();

        mSignal *= mAmplitude;
        mSignal += mOffset;
        return mSignal;
    }

    void process(float* signal_buffer, const uint32_t buffer_length) {
        for (uint16_t i = 0; i < buffer_length; i++) {
            signal_buffer[i] = process();
        }
    }

private:
    static constexpr float PIf                 = (float) PI;
    static constexpr float TWO_PIf             = (float) TWO_PI;
    static constexpr float M_DEFAULT_AMPLITUDE = 0.75f;
    static constexpr float M_DEFAULT_FREQUENCY = 220.0f;
    float*                 mWavetable;
    const uint32_t         mWavetableSize;
    const uint32_t         mSamplingRate;
    bool                   fDeleteWavetable;
    float                  mAmplitude;
    float                  mArrayPtr;
    float                  mDesiredAmplitude;
    float                  mDesiredAmplitudeFraction;
    uint16_t               mDesiredAmplitudeSteps;
    float                  mDesiredFrequency;
    float                  mDesiredFrequencyFraction;
    uint16_t               mDesiredFrequencySteps;
    float                  mFrequency;
    float                  mJitterRange;
    float                  mOffset;
    float                  mPhaseOffset;
    float                  mSignal;
    float                  mStepSize;

    void advance_array_ptr() {
        // mArrayPtr += mStepSize * (mEnableJitter ? (klangwellen::Klangwellen::random() * mJitterRange + 1.0f) : 1.0f);
        // mArrayPtr += mStepSize;
        mArrayPtr += mStepSize;
        while (mArrayPtr >= mWavetableSize) {
            mArrayPtr -= mWavetableSize;
        }
        while (mArrayPtr < 0) {
            mArrayPtr += mWavetableSize;
        }
    }

    float computeStepSize() const {
        return mFrequency * (static_cast<float>(mWavetableSize) / static_cast<float>(mSamplingRate));
    }

    float next_sample() {
        const float mOutput = mWavetable[static_cast<int>(mArrayPtr)];
        advance_array_ptr();
        return mOutput;
    }
};
