Klangstrom/klangstrom-libraries/Klangstrom_Emulator/standalone/src/KLST--logotype-128x128.h

#pragma once
#include <cstdint>
// generated from: KLST--logotype-128x128.png

struct KLST__logotype_128x128 {
  static constexpr std::uint32_t WIDTH  = 128;
  static constexpr std::uint32_t HEIGHT = 128;
  static inline const std::uint32_t DATA[WIDTH * HEIGHT] = {
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
};
};
