Klangstrom/klangstrom-libraries/Klangstrom_KLST_PANDA_STM32/src/WM8904Configure.cpp

/*
* Klangstrom
*
* This file is part of the *Klangstrom* library (https://github.com/dennisppaul/klangstrom-libraries).
* Copyright (c) 2025 Dennis P Paul.
*
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
* You should have received a copy of the GNU General Public License
* along with this program. If not, see <http://www.gnu.org/licenses/>.
*/

#include "KlangstromEnvironment.h"
#ifdef KLST_ARCH_IS_STM32
#include "PeripheralConfiguration_STM32.h"
#ifdef KLST_PERIPHERAL_ENABLE_AUDIODEVICE

#include <cstdio>
#include <cstdint>
#include "main.h"

#include "Console.h"
#include "WM8904Configure.h"
#include "WM8904.h"

#ifdef __cplusplus
extern "C" {
#endif

static void delay_ms(uint32_t duration) {
    HAL_Delay(duration);
}

static void set_lineout_volume(uint8_t volume_left, uint8_t volume_right) {
    WM8904_write_register(WM8904_R59_ANALOGUE_OUT2_LEFT, WM8904_LINEOUT_VU | WM8904_LINEOUTL_VOL(volume_left));
    WM8904_write_register(WM8904_R60_ANALOGUE_OUT2_RIGHT, WM8904_LINEOUT_VU | WM8904_LINEOUTR_VOL(volume_right));
}

static void set_headphone_volume(uint8_t volume_left, uint8_t volume_right) {
    WM8904_write_register(WM8904_R57_ANALOGUE_OUT1_LEFT, WM8904_HPOUT_VU | WM8904_HPOUTL_VOL(volume_left));
    WM8904_write_register(WM8904_R58_ANALOGUE_OUT1_RIGHT, WM8904_HPOUT_VU | WM8904_HPOUTR_VOL(volume_right));
}

static void setup_manually() {
    /* --- POWER ---------------------------------------------------------------------------------------------------- */
    WM8904_write_register(WM8904_BIAS_CONTROL_0, WM8904_ISEL_HP_BIAS);
    WM8904_write_register(WM8904_VMID_CONTROL_0, WM8904_VMID_BUF_ENA | WM8904_VMID_RES_FAST | WM8904_VMID_ENA);
    delay_ms(5);
    WM8904_write_register(WM8904_VMID_CONTROL_0, WM8904_VMID_BUF_ENA | WM8904_VMID_RES_NORMAL | WM8904_VMID_ENA);
    WM8904_write_register(WM8904_BIAS_CONTROL_0, WM8904_ISEL_HP_BIAS | WM8904_BIAS_ENA);
    WM8904_write_register(WM8904_POWER_MANAGEMENT_0, WM8904_INL_ENA | WM8904_INR_ENA);
    WM8904_write_register(WM8904_POWER_MANAGEMENT_2, WM8904_HPL_PGA_ENA | WM8904_HPR_PGA_ENA);
    WM8904_write_register(WM8904_DAC_DIGITAL_1, WM8904_DEEMPH(0));
    WM8904_write_register(WM8904_ANALOGUE_OUT12_ZC, 0x0000);
    WM8904_write_register(WM8904_CHARGE_PUMP_0, WM8904_CP_ENA);
    WM8904_write_register(WM8904_CLASS_W_0, WM8904_CP_DYN_PWR);

    /* --- AUDIO_INTERFACE ------------------------------------------------------------------------------------------ */
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
