Klangstrom/klangstrom-libraries/(commit log)

2021-05-04 moved files from main repo
    ( commit history of KLST_CORE + KLST_TINY is available at main repository )
    [ButtonDebounced.sch, KLST_CORE-BOM.csv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]
2021-05-04 made links to footprint + schematics library relative
2021-05-04 swapped SDCARD_CS + GPIO_02 to allow *hardware* CS
    [KLST_CORE.sch]
2021-05-17 added note for ARM-JTAG connector
    [KLST_TINY.kicad_pcb]
2021-07-23 updated version
    [ButtonDebounced.sch, KLST_TINY.sch, audio_codec_WM8731.sch, peripherals_uart_i2c_spi.sch, rotary_encoder__with_push_button.sch]
2021-10-11 updated schematics, started PCB
    [ButtonDebounced.sch, KLST_SHEEP.kicad_pcb, KLST_SHEEP.sch, audio_codec_WM8731.sch, peripherals_uart_i2c_spi.sch, rotary_encoder__with_push_button.sch]
2021-10-14 reworking PCB into *handheld* version
    [KLST_SHEEP.kicad_pcb]
2021-10-28 minor changes
    [KLST_SHEEP.kicad_pcb, KLST_SHEEP.sch]
2021-11-01 added NHD display
    [ButtonDebounced.sch, KLST_SHEEP.kicad_pcb, KLST_SHEEP.sch, audio_codec_WM8731.sch, peripherals_uart_i2c_spi.sch, rotary_encoder__with_push_button.sch]
2021-11-03 added screen, added icon
    [ButtonDebounced.sch, KLST_SHEEP.kicad_pcb, KLST_SHEEP.sch, audio_codec_WM8731.sch, peripherals_uart_i2c_spi.sch, rotary_encoder__with_push_button.sch]
2021-11-04 updated capabilites, updated GPIOs
    [ButtonDebounced.sch, KLST_SHEEP.kicad_pcb, KLST_SHEEP.sch, peripherals_uart_i2c_spi.sch]
2021-11-05 cleaned up
    [KLST_SHEEP.kicad_pcb, KLST_SHEEP.sch]
2021-11-05 added icons
    [ButtonDebounced.sch, KLST_SHEEP.kicad_pcb, KLST_SHEEP.sch, audio_codec_WM8731.sch, peripherals_uart_i2c_spi.sch, rotary_encoder__with_push_button.sch]
2021-11-06 finished PIN assignment, cleaned up silkscreen
    READY TO ROUTE :)
    [KLST_SHEEP.kicad_pcb, KLST_SHEEP.sch, peripherals_uart_i2c_spi.sch]
2021-11-06 updated info and tech details
    [KLST_SHEEP.sch]
2021-11-08 routed audio codec + connectors
    [KLST_SHEEP.kicad_pcb]
2021-11-08 started routing GPIOs + LEDs
    [KLST_SHEEP.kicad_pcb, KLST_SHEEP.sch, peripherals_uart_i2c_spi.sch, rotary_encoder__with_push_button.sch]
2021-11-08 finalized PCB design (v0.1)
    [KLST_SHEEP.kicad_pcb, KLST_SHEEP.sch, rotary_encoder__with_push_button.sch]
2021-11-25 added KLST_GRASS ( power + protoyping board )
    [KLST_GRASS.kicad_pcb, KLST_GRASS.sch, KLST_SHEEP.sch, charger_stepup.sch]
2021-11-25 finished schematics, started PCB design
    [KLST_GRASS.kicad_pcb, KLST_GRASS.sch]
2021-11-26 fixed components not showing in position file ( set to SMD )
    [KLST_GRASS.kicad_pcb, KLST_SHEEP.kicad_pcb]
2021-12-02 reversed LED naming
    [KLST_SHEEP.kicad_pcb, KLST_SHEEP.sch]
2021-12-03 updated pin map
2021-12-04 added LED timer map
2022-05-17 updated timer pin maps
2022-09-05 cleaned up release
    [KLST_TINY-BOM.csv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]
2022-09-08 added STM32H723ZGT6
    [KLST_PANDA.kicad_pcb, KLST_PANDA.kicad_sch]
2022-09-29 added STM32CubeIDE board configuration
2022-09-29 renamed board file folder
2022-10-02 added external memory + SDMMC card
    [KLST_PANDA.kicad_sch]
2022-10-04 added audiocodec
    [KLST_PANDA.kicad_pcb, KLST_PANDA.kicad_sch]
2022-10-05 rearranged pins, added modules from KLST_SHEEP
    [KLST_PANDA.kicad_sch]
2023-02-03 added KLST_SPIDER
    [KLST_SPIDER.kicad_pcb, KLST_SPIDER.kicad_sch]
2023-02-04 added connectors, created round PCB
    [KLST_SPIDER.kicad_pcb, KLST_SPIDER.kicad_sch]
2023-02-04 added MIDI THRU
    [KLST_SPIDER.kicad_pcb, KLST_SPIDER.kicad_sch]
2023-02-05 rearranged connectors
    [KLST_SPIDER.kicad_pcb, KLST_SPIDER.kicad_sch]
2023-02-06 prepared JLPCPB production
    [KLST_SPIDER.kicad_pcb, KLST_SPIDER.kicad_sch, klst_satellite.kicad_sch]
2023-02-06 renamed project, routed traces
    [KLST_OCTOPUS.kicad_pcb, KLST_OCTOPUS.kicad_sch, KLST_SPIDER.kicad_pcb, klst_satellite.kicad_sch]
2023-02-07 finished PCB routing
    [KLST_OCTOPUS.kicad_pcb, KLST_OCTOPUS.kicad_sch]
2023-02-07 finalized PCB
    [KLST_OCTOPUS.kicad_pcb, KLST_OCTOPUS.kicad_sch, klst_satellite.kicad_sch]
2023-02-07 fixed schematics
    [KLST_OCTOPUS.kicad_sch, klst_satellite.kicad_sch]
2023-02-07 updated LCSC #
    [KLST_OCTOPUS.kicad_sch, klst_satellite.kicad_sch]
2023-02-07 added LCSC #
    [KLST_OCTOPUS.kicad_pcb]
2023-02-07 prepared components for production
    [KLST_OCTOPUS.kicad_pcb, KLST_OCTOPUS.kicad_sch, bom.csv, designators.csv, klst_satellite.kicad_sch, positions.csv]
2023-02-08 corrected C1 ( to 100nF )
    [KLST_OCTOPUS.kicad_pcb, KLST_OCTOPUS.kicad_sch, bom.csv]
2023-02-20 fixed bug with TX + buffer
    [KLST_OCTOPUS.kicad_sch, klst_satellite.kicad_sch]
2023-02-22 KLST_SHEEP rotated diodes at UARTs
    [ButtonDebounced.kicad_sch, KLST_SHEEP.kicad_sch, audio_codec_WM8731.kicad_sch, peripherals_uart_i2c_spi.kicad_sch, rotary_encoder__with_push_button.kicad_sch]
2023-04-11 updated pin configuration
2023-04-11 optimized timer pins
2023-04-14 added components
    [KLST_PANDA.kicad_sch]
2023-05-02 added backlight PWM
2023-05-08 added KLST_SOIL
    [BOM-KLST_SOIL.csv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]
2023-05-22 added pin map
    [KLST_PANDA-STM32H723ZGT-BSP--pin_map.csv]
2023-08-04 separated sections into sheets
    [KLST_PANDA.kicad_pcb, KLST_PANDA.kicad_sch, audio_codec.kicad_sch, display.kicad_sch, external_memory.kicad_sch, sd_card.kicad_sch]
2023-08-07 updated architecture, switch mechanical key pins
    [KLST_PANDA-STM32H723ZGT-BSP--pin_map.csv]
2023-08-08 rearrange mechanical key pins, migrated to TP5400 charging circuit
    [KLST_PANDA.kicad_sch, battery.kicad_sch]
2023-08-10 added backlight circuit, started capacitive touch driver
    [KLST_PANDA.kicad_sch, battery.kicad_sch, display.kicad_sch]
2023-08-16 updated display module
    [KLST_PANDA.kicad_pcb, display.kicad_sch]
2023-08-17 added, rotary encoders, updated pin assignment, updated system architecture
    [KLST_PANDA-STM32H723ZGT-BSP--pin_map.csv, KLST_PANDA.kicad_sch, battery.kicad_sch, display.kicad_sch, rotary_encoder.kicad_sch, rotary_encoders.kicad_sch]
2023-08-17 added IDC, updated pin names
    [IDC_serial.kicad_sch, IDC_serials.kicad_sch, KLST_PANDA-STM32H723ZGT-BSP--pin_map.csv, KLST_PANDA.kicad_sch, rotary_encoders.kicad_sch]
2023-08-17 added MIDI analog, I2C and buttons
    [I2C.kicad_sch, IDC_serials.kicad_sch, KLST_PANDA.kicad_sch, MIDI_analog.kicad_sch, button_debounced.kicad_sch, buttons.kicad_sch]
2023-08-17 added USB-C connectors
    [KLST_PANDA.kicad_sch, USB.kicad_sch, battery.kicad_sch]
2023-08-18 cleaned up main sheet
    [KLST_PANDA.kicad_sch, MIDI_analog.kicad_sch, USB.kicad_sch, audio_codec.kicad_sch, battery.kicad_sch, display.kicad_sch]
2023-08-22 updated pin names, configured all pins and most peripherals,
    [ADC_DAC.kicad_sch, GPIO.kicad_sch, KLST_PANDA-STM32H723ZGT-BSP--pin_map.csv, KLST_PANDA.kicad_sch, audio_codec.kicad_sch, buttons.kicad_sch, display.kicad_sch, external_memory.kicad_sch]
2023-08-23 improved GPIO, updated schematics
    [ADC_DAC.kicad_sch, GPIO.kicad_sch, I2C.kicad_sch, IDC_serial.kicad_sch, KLST_PANDA.kicad_sch, MIDI_analog.kicad_sch, USB.kicad_sch, audio_codec.kicad_sch]
2023-08-23 added PDM interface ( and removed SAI )
    [GPIO.kicad_sch, KLST_PANDA-STM32H723ZGT-BSP--pin_map.csv, KLST_PANDA.kicad_sch, on-board_mic.kicad_sch]
2023-08-23 added MEMS mics
    [on-board_mic.kicad_sch]
2023-08-24 added mechanical keys, updated audio jacks, minor changes
    [ADC_DAC.kicad_sch, GPIO.kicad_sch, KLST_PANDA.kicad_pcb, KLST_PANDA.kicad_sch, MIDI_analog.kicad_sch, USB.kicad_sch, audio_codec.kicad_sch, buttons.kicad_sch]
2023-08-28 moved core (MCU) to sheet, cleaned up sheets
    [ADC_DAC.kicad_sch, GPIO.kicad_sch, I2C.kicad_sch, IDC_serial.kicad_sch, IDC_serials.kicad_sch, KLST_PANDA.kicad_sch, MIDI_analog.kicad_sch, USB.kicad_sch]
2023-08-28 started cleaning up schematic ( addressing DRC errors/warning ) (WIP)
    [ADC_DAC.kicad_sch, GPIO.kicad_sch, I2C.kicad_sch, IDC_serial.kicad_sch, KLST_PANDA.kicad_sch, MIDI_analog.kicad_sch, USB.kicad_sch, audio_codec.kicad_sch]
2023-08-29 changed `GPIO_20` to `GPIO_06` ( which was missing )
    [GPIO.kicad_sch, KLST_PANDA-STM32H723ZGT-BSP--pin_map.csv, core.kicad_sch]
2023-08-29 added battery clip, updated to new KiCad version
    [ADC_DAC.kicad_sch, GPIO.kicad_sch, IDC_serial.kicad_sch, KLST_PANDA.kicad_pcb, KLST_PANDA.kicad_sch, MIDI_analog.kicad_sch, USB.kicad_sch, audio_codec.kicad_sch]
2023-08-29 updated encoder symbol, ignored simulation errors
    [rotary_encoder.kicad_sch]
2023-08-29 updated 74AHC1G125 symbol
    [MIDI_analog.kicad_sch]
2023-08-29 update SD card symbol
    [sd_card.kicad_sch]
2023-08-29 removed DRC warnings and error, added power page
    [ADC_DAC.kicad_sch, GPIO.kicad_sch, I2C.kicad_sch, IDC_serial.kicad_sch, KLST_PANDA.kicad_sch, MIDI_analog.kicad_sch, USB.kicad_sch, audio_codec.kicad_sch]
2023-08-30 changed I2C label, display can now be switched on and off
    [ADC_DAC.kicad_sch, GPIO.kicad_sch, I2C.kicad_sch, IDC_serial.kicad_sch, KLST_PANDA.kicad_sch, MIDI_analog.kicad_sch, USB.kicad_sch, audio_codec.kicad_sch]
2023-08-31 unified internal I2C bus, cleaned up, added ESD protection to USB
    [ADC_DAC.kicad_sch, GPIO.kicad_sch, IDC_serial.kicad_sch, KLST_PANDA-STM32H723ZGT-BSP--pin_map.csv, KLST_PANDA.kicad_sch, MIDI_analog.kicad_sch, USB.kicad_sch, audio_codec.kicad_sch]
2023-08-31 removed GDNA
    [ADC_DAC.kicad_sch, GPIO.kicad_sch, IDC_serial.kicad_sch, MIDI_analog.kicad_sch, USB.kicad_sch, audio_codec.kicad_sch, battery.kicad_sch, button_debounced.kicad_sch]
2023-08-31 resolved TODOs
    [ADC_DAC.kicad_sch, KLST_PANDA.kicad_sch, MIDI_analog.kicad_sch, USB.kicad_sch, audio_codec.kicad_sch, battery.kicad_sch, core.kicad_sch, display.kicad_sch]
2023-08-31 started spec'ing components
    [ADC_DAC.kicad_sch, GPIO.kicad_sch, IDC_serial.kicad_sch, KLST_PANDA.kicad_pcb, KLST_PANDA.kicad_sch, MIDI_analog.kicad_sch, USB.kicad_sch, audio_codec.kicad_sch]
2023-09-01 assigned footprints
    [ADC_DAC.kicad_sch, GPIO.kicad_sch, KLST_PANDA.kicad_pcb, KLST_PANDA.kicad_sch, MIDI_analog.kicad_sch, USB.kicad_sch, audio_codec.kicad_sch, battery.kicad_sch]
2023-09-01 cleaned up footprint assignment
    [ADC_DAC.kicad_sch, GPIO.kicad_sch, IDC_serial.kicad_sch, KLST_PANDA.kicad_sch, MIDI_analog.kicad_sch, USB.kicad_sch, audio_codec.kicad_sch, battery.kicad_sch]
2023-09-02 added slider switch
    [KLST_PANDA.kicad_pcb, battery.kicad_sch]
2023-09-04 fixed 3D models, started sketch PCB layout
    [KLST_PANDA.kicad_pcb, KLST_PANDA.kicad_sch, on-board_mic.kicad_sch]
2023-09-05 started design + PCB layout research
    [KLST_PANDA.kicad_pcb]
2023-09-05 spec'd layers, restarted components placement
    [KLST_PANDA.kicad_pcb]
2023-09-05 lining up things for routing
    [KLST_PANDA.kicad_pcb]
2023-09-09 arranged components
    [KLST_PANDA.kicad_pcb]
2023-09-10 distributed modules
    [GPIO.kicad_sch, IDC_serial.kicad_sch, KLST_PANDA.kicad_pcb, KLST_PANDA.kicad_sch, USB.kicad_sch, audio_codec.kicad_sch, battery.kicad_sch, core.kicad_sch]
2023-09-11 spec'd capabilites, routed external memory
    [KLST_PANDA.kicad_pcb]
2023-09-13 finished positioning all components
    [KLST_PANDA.kicad_pcb]
2023-09-14 routed some components
    [KLST_PANDA.kicad_pcb, USB.kicad_sch, battery.kicad_sch, programmer.kicad_sch, rotary_encoder.kicad_sch]
2023-09-28 routed audio codec
    [KLST_PANDA.kicad_pcb]
2023-09-29 routed LCD + audio codec
    [KLST_PANDA.kicad_pcb]
2023-10-04 continued routing
    [IDC_serials.kicad_sch, KLST_PANDA.kicad_pcb, USB.kicad_sch, core.kicad_sch]
2023-10-04 routed GPIO
    [KLST_PANDA.kicad_pcb]
2023-10-05 completed routing, passed DRC
    [KLST_PANDA.kicad_pcb]
2023-10-05 moved ports
    [KLST_PANDA.kicad_pcb]
2023-10-06 added ( maybe fit ) Samtec FTSH-107-01-F-DV-K for programmer
    [programmer.kicad_sch]
2023-12-11 added TP5400, added labels
    [KLST_PANDA.kicad_pcb]
2023-12-11 added production files
    [BOM-KLST_PANDA.csv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]
2023-12-19 added resistor and capacitor, cleaned up TODOs
    [ADC_DAC.kicad_sch, GPIO.kicad_sch, IDC_serial.kicad_sch, KLST_PANDA.kicad_pcb, KLST_PANDA.kicad_sch, MIDI_analog.kicad_sch, USB.kicad_sch, audio_codec.kicad_sch]
2023-12-20 finalized PCB layout
    [KLST_PANDA.kicad_pcb, battery.kicad_sch, display.kicad_sch]
2023-12-20 generated production files
    [BOM-KLST_PANDA.csv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]
2023-12-20 changed via size to 0.3mm
    [KLST_PANDA.kicad_pcb]
2023-12-20 updated production files
    [KLST_PANDA-CuBottom.gbr, KLST_PANDA-CuIn1.gbr, KLST_PANDA-CuIn2.gbr, KLST_PANDA-CuIn3.gbr, KLST_PANDA-CuIn4.gbr, KLST_PANDA-CuTop.gbr, KLST_PANDA-EdgeCuts.gbr, KLST_PANDA-MaskBottom.gbr]
2023-12-20 removed mounting holes from BOM
    [BOM-KLST_PANDA.csv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]
2023-12-20 replaced R42
    [BOM-KLST_PANDA.csv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]
2024-01-10 production version
    [KLST_PANDA-CuBottom.gbr, KLST_PANDA-CuIn1.gbr, KLST_PANDA-CuIn2.gbr, KLST_PANDA-CuIn3.gbr, KLST_PANDA-CuIn4.gbr, KLST_PANDA-CuTop.gbr, KLST_PANDA-EdgeCuts.gbr, KLST_PANDA-MaskBottom.gbr]
2024-01-12 fixed hole size issue with audio jacks
    [KLST_PANDA-CuBottom.gbr, KLST_PANDA-CuIn1.gbr, KLST_PANDA-CuIn2.gbr, KLST_PANDA-CuIn3.gbr, KLST_PANDA-CuIn4.gbr, KLST_PANDA-CuTop.gbr, KLST_PANDA-EdgeCuts.gbr, KLST_PANDA-MaskBottom.gbr]
2024-01-12 replaced audio jack
    [KLST_PANDA.kicad_pcb]
2024-01-12 changed vias to 0.5/0.2mm, removed edge cut from footprint
    [KLST_PANDA.kicad_pcb]
2024-01-12 replaced audio jacks and fixed all errors and warnings
    [KLST_PANDA.kicad_pcb]
2024-01-12 finalized production files
    [BOM-KLST_PANDA.csv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]
2024-01-31 started testing KLST_PANDA board
    [KLST_PANDA-STM32H723ZGT-BSP Debug.cfg]
2024-02-02 started updating PCB
    [ADC_DAC.kicad_sch, GPIO.kicad_sch, IDC_serial.kicad_sch, KLST_PANDA.kicad_sch, MIDI_analog.kicad_sch, USB.kicad_sch, audio_codec.kicad_sch, battery.kicad_sch]
2024-02-02 external memory is working … but misses a few spots
2024-02-02 ext memory is now ALMOST working …
2024-02-04 LCD clears background now … but does not update
2024-02-04 LCD works now with DMA2D
    … not exactly sure what i am doing here though ;)
2024-02-05 set LCD GPIO pin speeds to very high
2024-02-05 imporved OCTO-SPI performance
2024-02-10 audiocodec still not working
    [KLST_PANDA-AudioCodec.c, KLST_PANDA-SerialDebug.h, WM8904.h]
2024-02-12 clean up, still not working
    [KLST_PANDA-AudioCodec.c]
2024-02-13 fixed D-chache issue with DMA
    [KLST_PANDA-AudioCodec.c]
2024-02-15 PDM mic not working yet
    [KLST_PANDA-AudioCodec.c]
2024-02-17 minor changes … PDM MIC still not working
    [KLST_PANDA-AudioCodec.c]
2024-02-17 started encoders ( in C++ ), minor changes
2024-02-18 added SDCard support ( no DMA )
2024-02-19 started adding IDC ( still not working :( )
    [KLST_PANDA.cpp, main.h]
2024-02-20 fixed project file, still struggling with UART
    [KLST_PANDA.cpp]
2024-02-21 struggling with UART … still
2024-02-21 added buffer to UART ( still only semi functional )
2024-02-21 UART … puuuuh :(
    [MIDI_analog.kicad_sch]
2024-02-22 adde coding style, added rotary encoder,
2024-02-25 enabled DMA for SD Card
2024-02-25 cleaned up MIDI
    [MIDI_analog.kicad_sch]
2024-02-25 updated kicad files to 8.0
    [ADC_DAC.kicad_sch, GPIO.kicad_sch, IDC_serial.kicad_sch, IDC_serials.kicad_sch, KLST_PANDA.kicad_pcb, KLST_PANDA.kicad_sch, MIDI_analog.kicad_sch, USB.kicad_sch]
2024-02-26 UART8 uses DMA now
2024-02-26 added USB Host, enabled DMA for UART4+9 ( but not using it yet )
2024-02-26 added USB Device ( but deactivated )
2024-02-27 added ADC + DAC
2024-02-28 final got MIDI to work ( not sure if it is now TYPE A or B ;) )
    [MIDI_analog.kicad_sch]
2024-02-29 added display off when not used
    [MIDI_analog.kicad_sch]
2024-03-01 added on board mic files, deleted linker script *RAM.ld
2024-03-06 added report, update pin map
    [KLST_PANDA-STM32H723ZGT-BSP--pin_map.csv]
2024-03-13 added +1.8V power, removed SS14, added decoupling capacitor to MEMS mic
    [MIDI_analog.kicad_sch, audio_codec.kicad_sch, battery.kicad_sch, on-board_mic.kicad_sch, power.kicad_sch]
2024-03-13 rearranged SPI and added DFSDM
    [GPIO.kicad_sch, core.kicad_sch]
2024-03-13 added DFSDM channels + filters
2024-03-13 removed SAI from on-board mic
2024-03-14 removed SS14, moved `SPI_USR` to `SPI4` use `SPI2` for MEMS microphones, added decoupling caps to MEMS microphone, added +1.8V, fixed audio codec power supply
    [KLST_PANDA.kicad_sch, audio_codec.kicad_sch, battery.kicad_sch, power.kicad_sch]
2024-03-14 grouped modules
    [battery.kicad_sch]
2024-03-15 added KLST_CATERPILLAR
    [ADC_DAC.kicad_sch, GPIO.kicad_sch, IDC_serial.kicad_sch, IDC_serials.kicad_sch, KLST_PANDA.kicad_sch, MIDI_analog.kicad_sch, USB.kicad_sch, audio_codec.kicad_sch]
2024-03-15 changed project name
    [ADC_DAC.kicad_sch, GPIO.kicad_sch, IDC_serial.kicad_sch, IDC_serials.kicad_sch, KLST_CATERPILLAR.kicad_sch, MIDI_analog.kicad_sch, USB.kicad_sch, audio_codec.kicad_sch]
2024-03-15 reduced modules
    [GPIO.kicad_sch, IDC_serial.kicad_sch, IDC_serials.kicad_sch, KLST_CATERPILLAR.kicad_pcb, KLST_CATERPILLAR.kicad_sch, buttons_keys.kicad_sch, core.kicad_sch]
2024-03-15 finished placing components
    [GPIO.kicad_sch, KLST_CATERPILLAR.kicad_pcb, audio_codec.kicad_sch]
2024-03-15 routed modules ( not finished )
    [KLST_CATERPILLAR.kicad_pcb, audio_codec.kicad_sch]
2024-03-16 finished routing
    [KLST_CATERPILLAR.kicad_pcb]
2024-03-16 added jlcpcb production files
    [BOM-KLST_CATERPILLAR.csv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]
2024-03-16 added GPIOs
    [GPIO.kicad_sch, KLST_CATERPILLAR.kicad_pcb, KLST_CATERPILLAR.kicad_sch, testpoints.kicad_sch]
2024-03-17 added test points, replaced unavailable components
    [BOM-KLST_CATERPILLAR.csv, GPIO.kicad_sch, IDC_serial.kicad_sch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]
2024-03-17 updated via drill hole size to 3mm
    [KLST_CATERPILLAR-CuBottom.gbr, KLST_CATERPILLAR-CuIn1.gbr, KLST_CATERPILLAR-CuIn2.gbr, KLST_CATERPILLAR-CuIn3.gbr, KLST_CATERPILLAR-CuIn4.gbr, KLST_CATERPILLAR-CuTop.gbr, KLST_CATERPILLAR-EdgeCuts.gbr, KLST_CATERPILLAR-MaskBottom.gbr]
2024-03-17 removed reference from GPIO
    [KLST_CATERPILLAR-CuBottom.gbr, KLST_CATERPILLAR-CuIn1.gbr, KLST_CATERPILLAR-CuIn2.gbr, KLST_CATERPILLAR-CuIn3.gbr, KLST_CATERPILLAR-CuIn4.gbr, KLST_CATERPILLAR-CuTop.gbr, KLST_CATERPILLAR-EdgeCuts.gbr, KLST_CATERPILLAR-MaskBottom.gbr]
2024-03-28 added note to connnect USB to 5V when without battery
    [battery.kicad_sch]
2024-03-28 fixed: connected 5V to USB power
    [KLST_CATERPILLAR-CuBottom.gbr, KLST_CATERPILLAR-CuIn1.gbr, KLST_CATERPILLAR-CuIn2.gbr, KLST_CATERPILLAR-CuIn3.gbr, KLST_CATERPILLAR-CuIn4.gbr, KLST_CATERPILLAR-CuTop.gbr, KLST_CATERPILLAR-EdgeCuts.gbr, KLST_CATERPILLAR-MaskBottom.gbr]
2024-03-28 added net tie for USB to 5V
    [KLST_CATERPILLAR-CuBottom.gbr, KLST_CATERPILLAR-CuIn1.gbr, KLST_CATERPILLAR-CuIn2.gbr, KLST_CATERPILLAR-CuIn3.gbr, KLST_CATERPILLAR-CuIn4.gbr, KLST_CATERPILLAR-CuTop.gbr, KLST_CATERPILLAR-EdgeCuts.gbr, KLST_CATERPILLAR-MaskBottom.gbr]
2024-05-14 added copy of STM32duino variant definition
2024-05-14 added script to develop variant with STM32duino
2024-05-27 cleaned up firmware, audio codec now works with ARDUINO IDE
2024-05-28 added LED, fixed print+println
2024-06-02 added LED view
2024-06-08 added SD Card ( not working ), added FatFS
    [bsp_driver_sd.c, bsp_driver_sd.h, diskio.c, diskio.h]
2024-06-09 SD Card now works in STM32CubeIDE but not arduino
2024-06-09 started adding KLST_CATERPILLAR variant ( pure arduino )
2024-06-09 fix interrupt functions
2024-06-11 added boards.txt, add pin definitions
2024-06-13 undef’d FatFs
2024-06-13 added SD card to DMA setup
2024-07-04 moved tools to klangstrom-stm32
2024-07-09 fixed warnings, updated formatting
    [FT5206.cpp, FT5206.h, Klangstrom.h, KlangstromAudioCodec_BSP_KLST_PANDA_STM32.h, KlangstromDefines.h, KlangstromEnvironment.h, WM8904.cpp, WM8904.h]
2024-07-24 reworked audio codec completely to use audioblocks (WIP)
    [KlangstromDefines.h]
2024-07-28 added device type, removed `KLANG_*` defines
2024-08-02 started reworking libraries to C-based style
    [ArrayList.h, KlangstromAudioCodec_BSP_KLST_PANDA_STM32.h, System.cpp, System.h, WM8904.cpp, WM8904.h]
2024-08-04 cleaned up audio device/codec
2024-08-05 reworked audio codec in C-style
    [AudioCodec.ino, AudioDevice.cpp, Console.h, KlangstromConfiguration.h, System.h]
2024-08-05 added pause to audio device, added LEDs
2024-08-06 added LEDs, added SDCard support
2024-08-09 added serial (UART), added tick,
2024-08-10 added cycle counter + clock freq (WIP), added DMA pool size, cleaned up
2024-08-12 added LED, audiodevice, SD card and IDC serial to KLST_CATERPILLAR
2024-08-12 fixed timing in EMU
    [ClockCyclesAndTicks.ino, Console.cpp, KlangstromConfiguration.h]
2024-08-13 fixed baud rate, struggled with UART, added MIDI
    [Beat.h, IDC.ino, KlangstromConfiguration.h, KlangstromMIDIParser.h, MIDI.cpp, MIDI.h, MIDI.ino, MIDIParser.h]
2024-08-13 added USB host library, remove interrupt exclusion
2024-08-16 removed USB from klangstromm added USB Device as library
2024-08-16 added USB Device
2024-08-16 removed USB Device
2024-08-17 fixed minor bugs, formatted code
    [ArrayList.h, MIDI.cpp, MIDI_application.cpp, PeripheralConfiguration_KLST_PANDA_STM32.h, SerialDevice_KLST_PANDA_CATERPILLAR.cpp, SerialDevice_STM32.cpp, TaskScheduler.h, USBDevices.cpp]
2024-08-17 added rotary encoder
2024-08-17 renamed rotary encoder to encoder, added callbacks to encoder
2024-08-18 added advanced example for custom GPIO pin, added option to trigger external interrupt for all 16 GPIO pins
2024-08-19 added DAC + ADC
2024-08-20 display is now working in single/double buffer mode ( with 60Hz animation ) and touch panel and backlight
2024-08-22 WIP … but DMA2D interaction is slowly improving
2024-08-22 puuuh struggling with DMA2D drawing … implemented a software renderer for now.
2024-08-22 struggling with DMA2D still … a lot
2024-08-22 LTDC can switch renderer, touch panel can be deactivated
2024-08-22 first naive attempt at ordering interrupts
2024-08-23 playing with interrupts … no success :(
2024-08-24 changed drill hole size to 0.3
2024-08-25 replaced out-of-stock resistors, excluded cherry keys from BOM
    [BOM-KLST_PANDA.csv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]
2024-08-25 replaced on-off switch
    [battery.kicad_sch]
2024-08-25 added 3D model
    [BOM-KLST_PANDA.csv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]
2024-08-25 moved on-off switch
    [CPL-KLST_PANDA.csv, KLST_PANDA-CuBottom.gbr, KLST_PANDA-CuIn1.gbr, KLST_PANDA-CuIn2.gbr, KLST_PANDA-CuIn3.gbr, KLST_PANDA-CuIn4.gbr, KLST_PANDA-CuTop.gbr, KLST_PANDA-EdgeCuts.gbr]
2024-08-27 tried to use ADC in DMA mode ( not working )
    [FT5206.cpp]
2024-08-30 updated parts
    [BOM-KLST_PANDA.csv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]
2024-08-31 fixed pixel allpha blending
    [Display.h, Display_EMU.cpp, DrawText.ino]
2024-09-02 reworked timer and beat for STM32
    [Beat.h, CallbackDefinitions.h, Key_STM32.cpp, PeripheralConfiguration_KLST_CATERPILLAR_EMU.h, PeripheralConfiguration_KLST_CATERPILLAR_STM32.h, PeripheralConfiguration_KLST_PANDA_STM32.h, System.cpp, System.h]
2024-09-02 cleaned up timer
2024-09-03 fixed Beat, cleaned up
    [AudioDevice_EMU.cpp, AudioDevice_EMU.h, Console_EMU.cpp, Display_EMU.cpp, HardwareTimer.h, KlangstromConfiguration.h, LED_EMU.cpp, PeripheralConfiguration_EMU.h]
2024-09-03 brought back emulator with arduino-cli
    ( feels like wrestling with some derranged creature … i do like the arduino project but the build system is something )
2024-09-03 ADC now uses DMA ( implementation needs some serious tuning )
2024-09-04 added adc to KLST_CATERPILLAR
2024-09-06 added READMEs, added options to change buffer sizes, fixed output in arduino-cli emulator,
    [AudioCodec.ino, AudioDevice_KLST_PANDA_CATERPILLAR.cpp, BeatAndTimer.ino, Console.cpp, DACADC.ino, DACADC_KLST_PANDA.cpp, KlangstromConfiguration.h, MIDI.cpp]
2024-09-07 added examples connecting to external devices
2024-09-23 fixed a severe PCB bug where +3V3 was connected to GND :( connected copper fill on outer layers to GND
    [BOM-KLST_PANDA.csv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]
2024-09-23 production ready for V2
    [KLST_PANDA-CuBottom.gbr, KLST_PANDA-CuIn1.gbr, KLST_PANDA-CuIn2.gbr, KLST_PANDA-CuIn3.gbr, KLST_PANDA-CuIn4.gbr, KLST_PANDA-CuTop.gbr, KLST_PANDA-EdgeCuts.gbr, KLST_PANDA-MaskBottom.gbr]
2024-12-04 removed errors, added mounting holes for LCD, added 傲慢と無知
    [CPL-KLST_PANDA.csv, KLST_PANDA-CuBottom.gbr, KLST_PANDA-CuIn1.gbr, KLST_PANDA-CuIn2.gbr, KLST_PANDA-CuIn3.gbr, KLST_PANDA-CuIn4.gbr, KLST_PANDA-CuTop.gbr, KLST_PANDA-EdgeCuts.gbr]
2024-12-13 production commit for v2.1
    [KLST_PANDA-CuBottom.gbr, KLST_PANDA-CuIn1.gbr, KLST_PANDA-CuIn2.gbr, KLST_PANDA-CuIn3.gbr, KLST_PANDA-CuIn4.gbr, KLST_PANDA-CuTop.gbr, KLST_PANDA-EdgeCuts.gbr, KLST_PANDA-MaskBottom.gbr]
2025-01-05 fixed KLST_TINY reversed diode, minor changes to KLST_PANDA
    [ButtonDebounced.kicad_sch, KLST_TINY.kicad_pcb, KLST_TINY.kicad_sch, audio_codec_WM8731.kicad_sch, peripherals_uart_i2c_spi.kicad_sch, rotary_encoder__with_push_button.kicad_sch]
2025-02-25 added KLST_PANDA_PROTO
    [BOM-KLST_PANDA_PROTO.csv, GPIO.kicad_sch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]
2025-09-10 changed backlight PWM frequency
2025-09-10 Squashed 'libraries/' changes from d036338..d0cd72a
    d0cd72a changed backlight PWM frequency
    git-subtree-dir: libraries
    git-subtree-split: d0cd72aea27642fa9eaa1a06ed8d2ddcecb2fa56
2025-09-12 moved old projects to attic
    [BOM-KLST_SOIL.csv, ButtonDebounced.sch, KLST_CORE-BOM.csv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]
2025-09-14 changed license, removed attic, update logotype
    [BOM-KLST_SOIL.csv, ButtonDebounced.sch, KLST_CORE-BOM.csv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]
2025-09-19 WIP fixed audio input
    [KLST_EMU_adapter.cpp, KlangstromEmulator.cpp, KlangstromEmulatorClient.cpp, TestSketch.cpp]
2025-09-19 improved audio device
2025-09-20 moved arduino functions to core
2025-09-22 renamed Timer to PeriodicTimer
2025-09-23 fixed example, added display example
    [AudioSDCardPlayWAV.cpp, Display.cpp, DisplayAnimation.cpp, KLST--ICON--128x128.h]
2025-09-23 started implementing encoder emulator
2025-09-24 added color functions, fixed examples, added script to test examples
    [AudioDevice.h, AudioDevice_KLST_PANDA_CATERPILLAR.cpp, AudioDevice_STM32.cpp, AudioSDCardStreamRaw.ino, AudioStreamFloat32.h, BeatAndTimer.ino, DACADC_EMU.cpp, Display.h]
2025-09-27 fixed examples, improved hardware timer precision in emulator
    [HardwareTimer.h, KeyCustom.ino]
2025-09-30 added templated map function, added example for external memory, fixed ext mem size in emulator
    [ArduinoFunctions.cpp, ExternalMemory.ino, System_EMU.cpp]
2025-10-02 added IDs for KLST_CATERPILLAR boards, fixed text align ( thank you seongjoo )
    [Draw.cpp, SystemUID.h, UID-no-display.ino, UID.ino]
