Klangstrom/klangstrom-libraries/(notices)

Notices in the files:
Klangstrom/src/KlangstromMIDIParser.h:
This library is free software: you can redistribute it and/or modify
it under the terms of the GNU General Public License as published by
the Free Software Foundation, version 3.
Klangstrom_KLST_PANDA_STM32_CubeMX/src/main.h:
Copyright (c) 2024 STMicroelectronics.
All rights reserved.
Klangstrom_KLST_PANDA_STM32_CubeMX/src/bsp_driver_sd.c:
Copyright (c) 2022 STMicroelectronics.
